D33pWat3r/Projects-for-Formula-Student-2019/Dashboard/Platinenaufbau_Platine_front.png

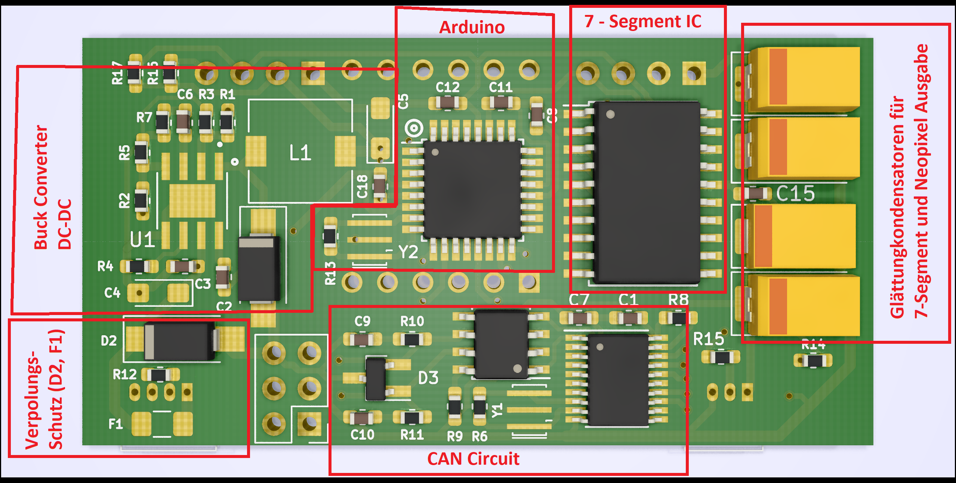
Dashboard/Platinenaufbau_Platine_front.png
