D33pWat3r/Projects-for-Formula-Student-2019/Dashboard/external Display (Add-On PCB)/Back.png

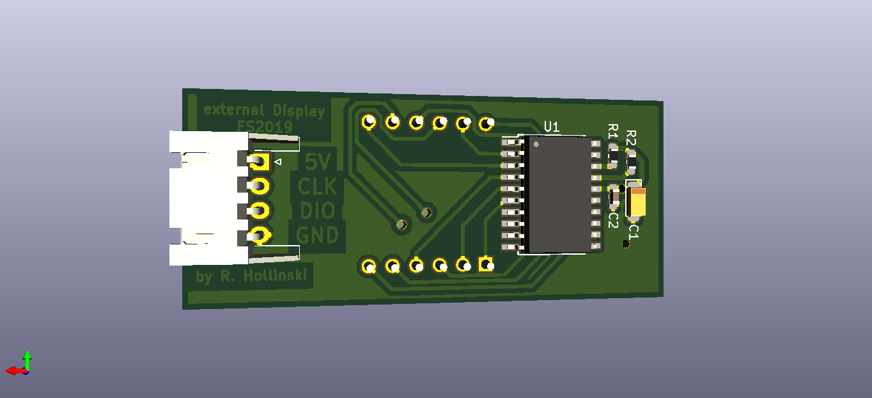
Dashboard/external Display (Add-On PCB)/Back.png
