D33pWat3r/Projects-for-Formula-Student-2019/Dashboard/OLED_vs_7Segment/Foto_vom_Steckbrett.jpg

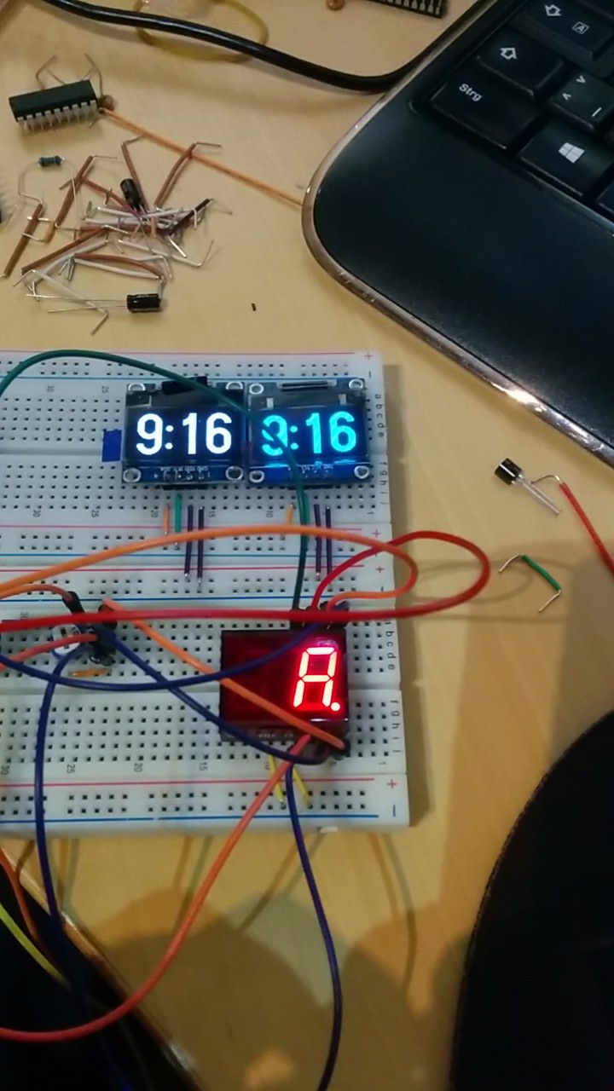
Dashboard/OLED_vs_7Segment/Foto_vom_Steckbrett.jpg
