D33pWat3r/Projects-for-Formula-Student-2019/Dashboard/PCB_KiCad_Files/RenderPictures/Platine_back_without.png

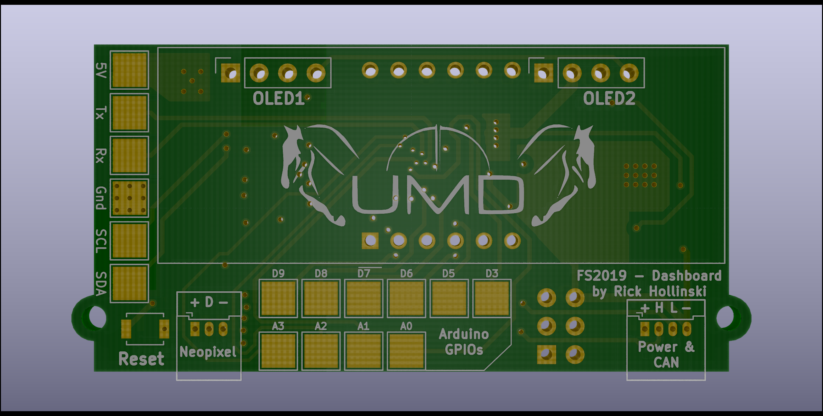
Dashboard/PCB_KiCad_Files/RenderPictures/Platine_back_without.png
