D33pWat3r/Projects-for-Formula-Student-2019/Dashboard/Platine_PinOut.png

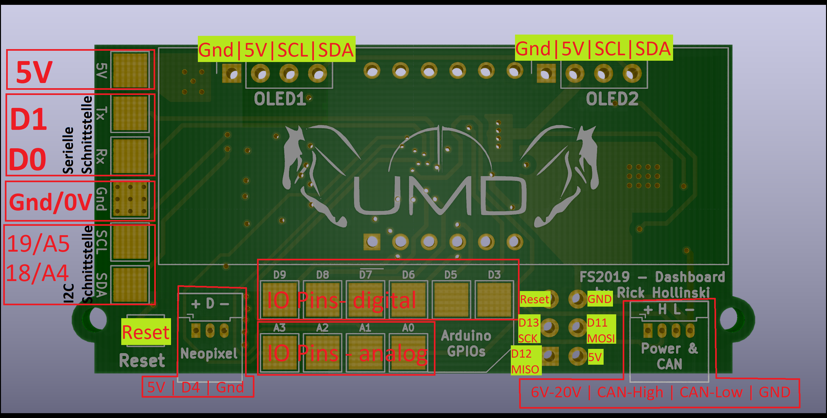
Dashboard/Platine_PinOut.png
