D33pWat3r/Projects-for-Formula-Student-2019/Dashboard/external Display (Add-On PCB)/Display.step

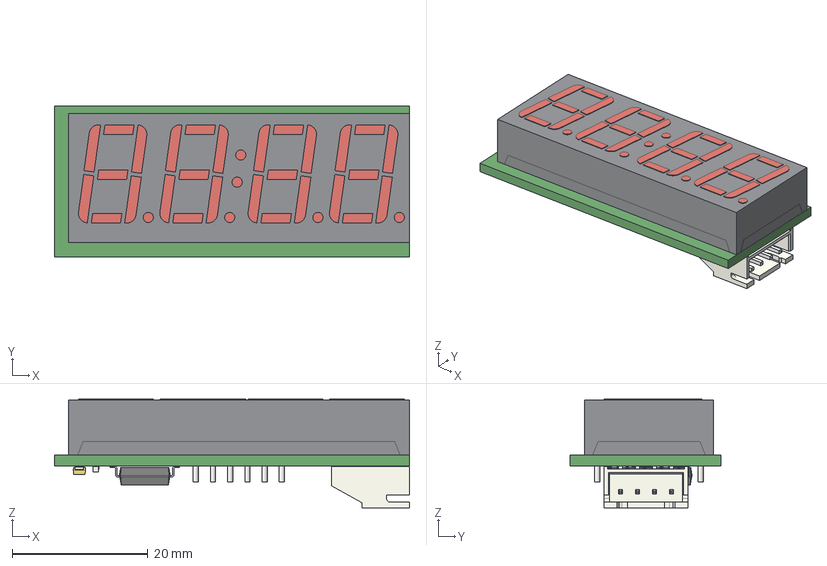
[picture p11: CAD file, 2020-06-07]
Dashboard/external Display (Add-On PCB)/Display.step
52.3 x 22.3 x 16.0 mm
