D33pWat3r/Projects-for-Formula-Student-2019/Dashboard/LED_Fassung.stl

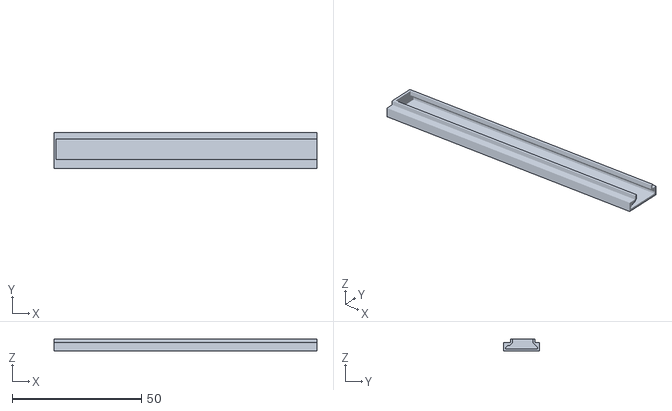
[picture p12: CAD file, 2020-06-07]
Dashboard/LED_Fassung.stl
101.8 x 14.1 x 4.80
