D33pWat3r/Projects-for-Formula-Student-2019/Dashboard/MountingBox/CFFFP_Box.3mf

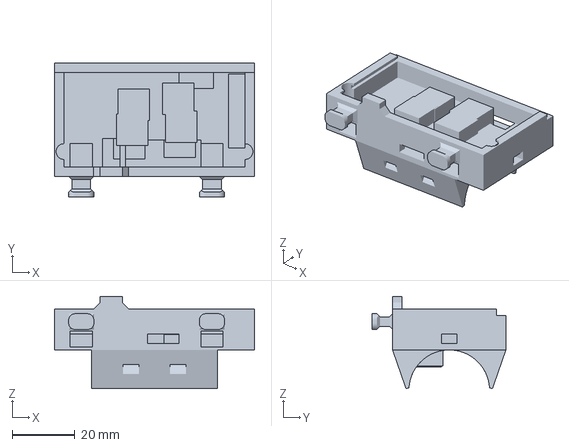
[picture p13: CAD file, 2020-06-07]
Dashboard/MountingBox/CFFFP_Box.3mf
63.5 x 42.5 x 29.3 mm
