D33pWat3r/Projects-for-Formula-Student-2019/Dashboard/PCB_KiCad_Files/3D_Modell/Dashboard PlatinenModell v1.step

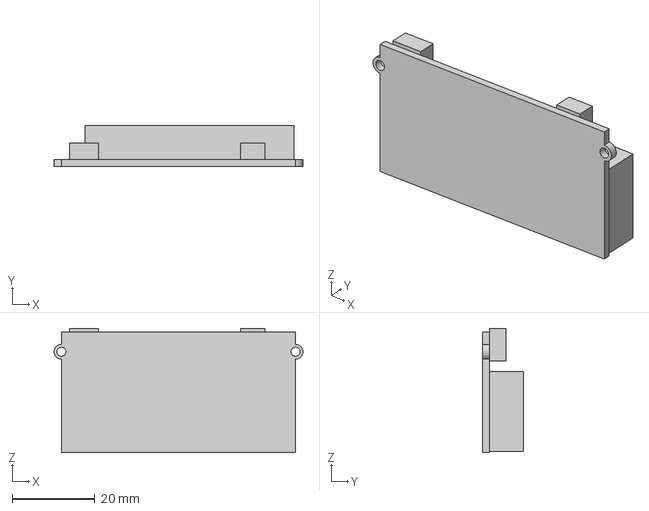
[picture p14: CAD file, 2020-06-07]
Dashboard/PCB_KiCad_Files/3D_Modell/Dashboard PlatinenModell v1.step
60.2 x 9.80 x 30.0 mm
