D33pWat3r/Projects-for-Formula-Student-2019/Dashboard/PCB_KiCad_Files/SVG/circuit-Edge.Cuts.dxf

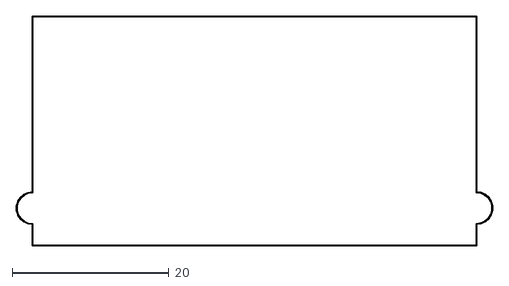
[picture p15: CAD file, 2020-06-07]
Dashboard/PCB_KiCad_Files/SVG/circuit-Edge.Cuts.dxf
60.8 x 29.3
