D33pWat3r/Projects-for-Formula-Student-2019/Dashboard/Dashboard_Panel.dxf

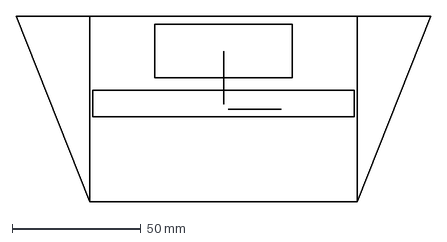
[picture p16: CAD file, 2020-06-07]
Dashboard/Dashboard_Panel.dxf
161.0 x 72.0 mm
