D33pWat3r/Projects-for-Formula-Student-2019/Dashboard/MountingBox/Box.stl

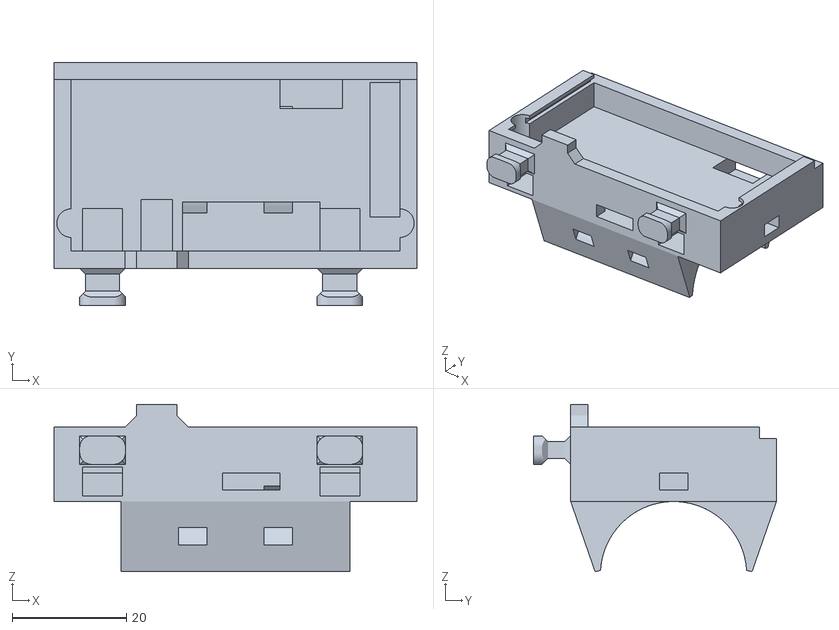
[picture p17: CAD file, 2020-06-07]
Dashboard/MountingBox/Box.stl
63.5 x 42.5 x 29.3
