D33pWat3r/Projects-for-Formula-Student-2019/Dashboard/PCB_KiCad_Files/3D_Modell/PCB_Dashboard.stl

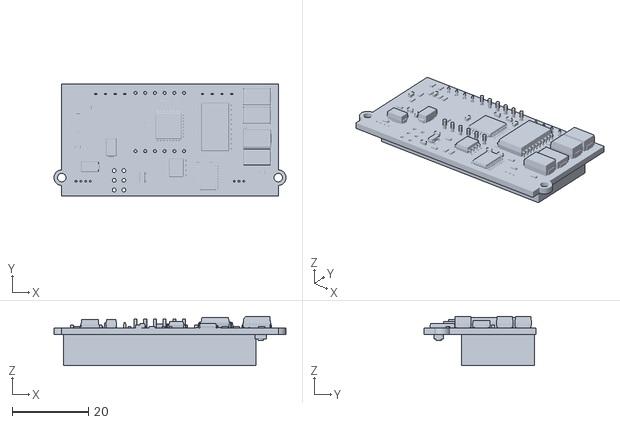
[picture p18: CAD file, 2020-06-07]
Dashboard/PCB_KiCad_Files/3D_Modell/PCB_Dashboard.stl
60.7 x 29.2 x 12.9
