D33pWat3r/Projects-for-Formula-Student-2019/Dashboard/MountingBox/Deckel.stl

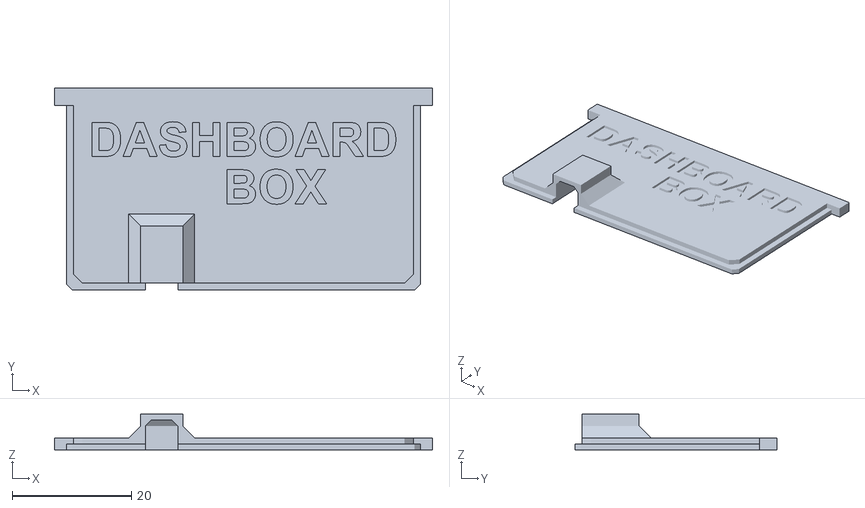
[picture p19: CAD file, 2020-06-07]
Dashboard/MountingBox/Deckel.stl
63.5 x 34.0 x 6.00
