D33pWat3r/Projects-for-Formula-Student-2019/(list of files, cad)

Other CAD files:
Dashboard/PCB_KiCad_Files/3D_Modell/Dashboard Modell.f3d
