D33pWat3r/Projects-for-Formula-Student-2019/Dashboard/SchematicFile.pdf

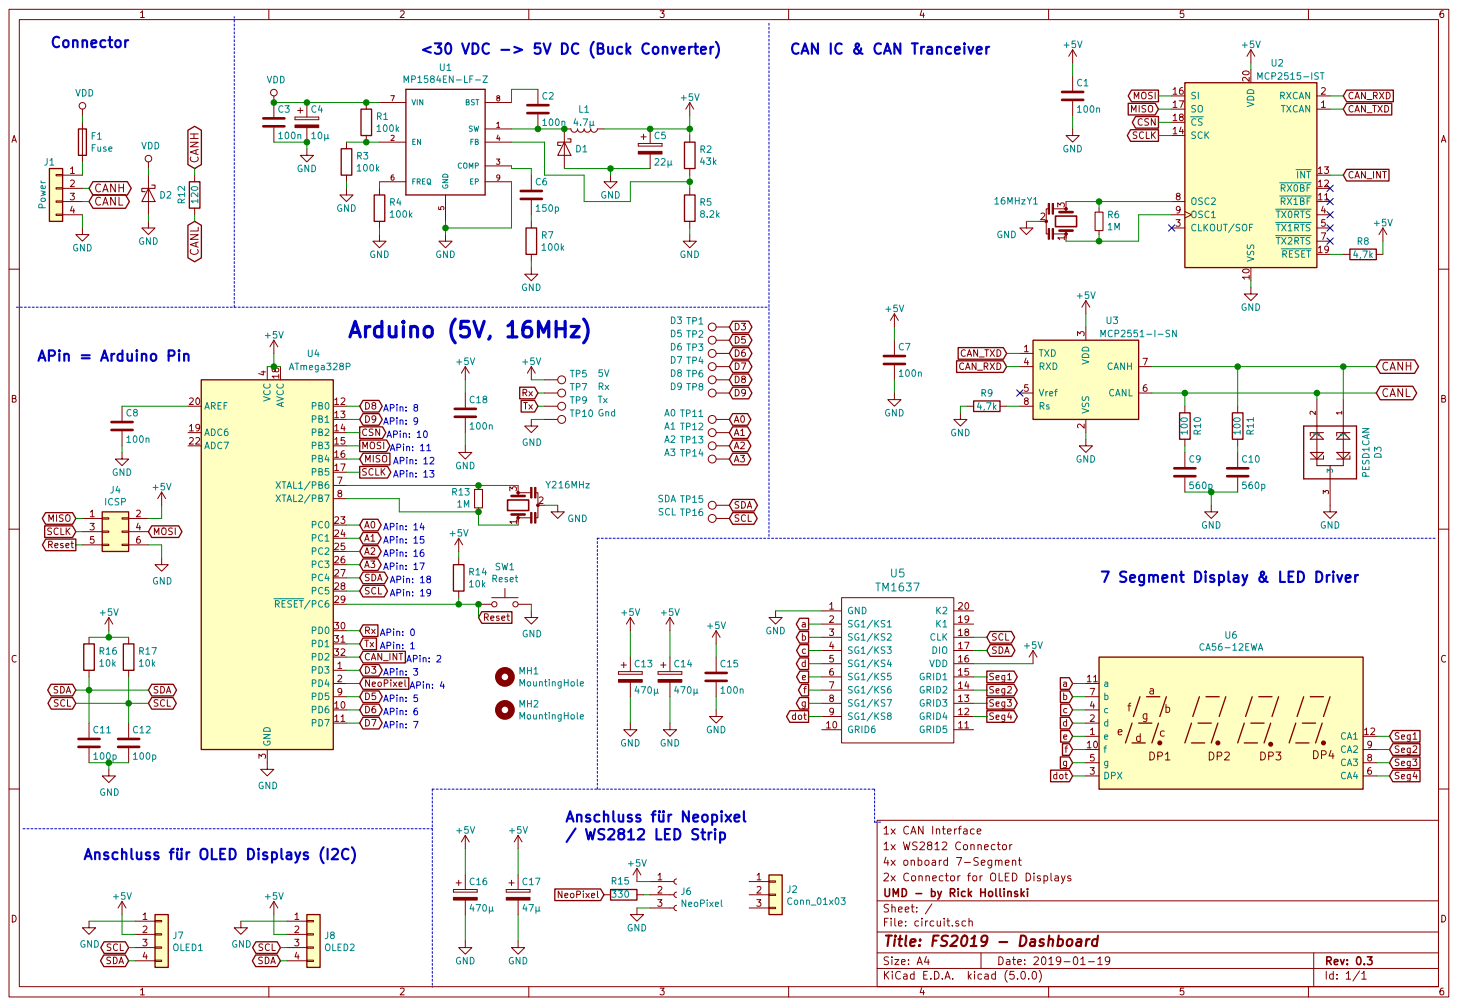
[picture p20: page 1]

<30 VDC -> 5V DC (Buck Converter) D2 VDD GNDCANH

CAN IC & CAN Tranceiver

5 FREQ 6 SW 1 COMP 3 EN 2 EP 9 BST 8 U1 MP1584EN-LF-Z R2

3 RXD 4 Vref 5 CANL 6 CANH 7 Rs 8 U3MCP2551-I-SN

J2Conn_01x03 APin: 0 APin: 1APin: 2 APin: 3APin: 4 APin: 5 APin: 7 APin: 6 APin: 8 APin: 9 APin: 10 APin: 11 APin: 12 APin: 13 APin: 14 APin: 15 APin: 16 APin: 17 APin: 18 APin: 19 APin = Arduino Pin

7 Segment Display & LED Driver

4x onboard 7-Segment 1x WS2812 Connector 1x CAN Interface

SCL SDA Anschluss für OLED Displays (I2C)

2x Connector for OLED Displays
File: circuit.sch Sheet: / UMD - by Rick Hollinski
