D33pWat3r/Projects-for-Formula-Student-2019/Dashboard/external Display (Add-On PCB)/Display.pdf

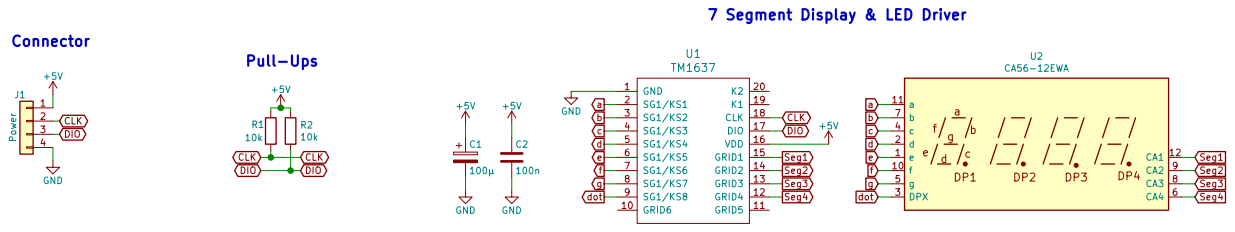
[picture p21: page 1]

File: Display.sch Sheet: /
Id: 1/1 Title:
