D33pWat3r/Projects-for-Formula-Student-2019/Dashboard/external Display (Add-On PCB)/Display.kicad_pcb

## KiCad design Dashboard/external Display (Add-On PCB)/Display.kicad_pcb (2020-06-07)

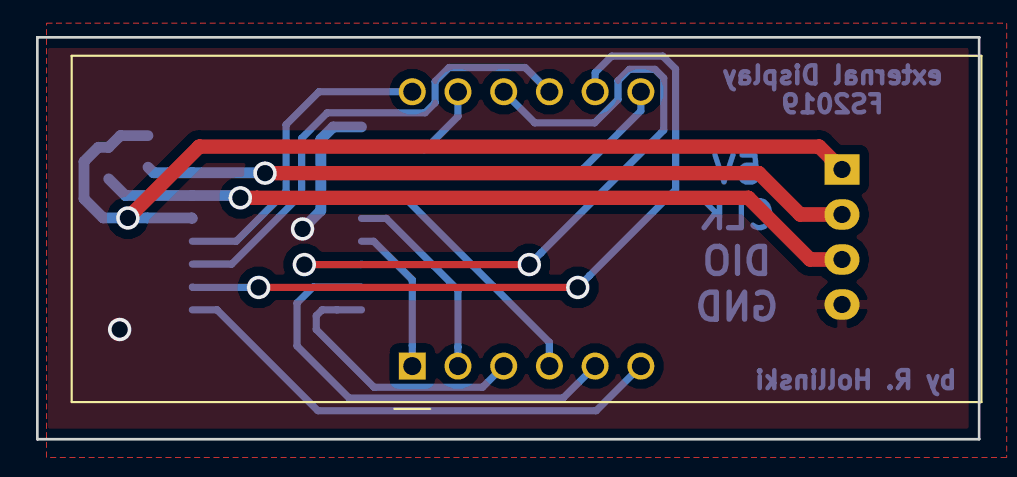
[picture p22: board Display.kicad_pcb from above]

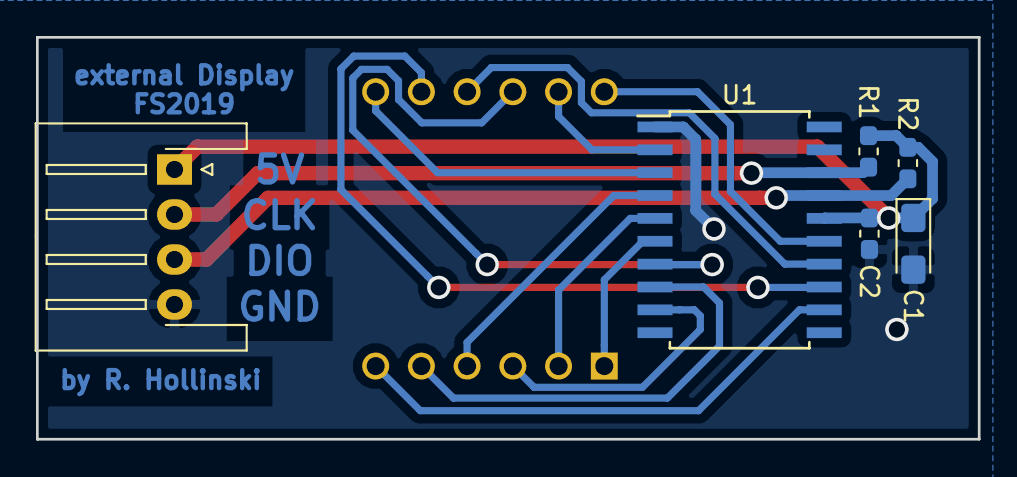
[picture p23: board Display.kicad_pcb from below]

Board: 2 copper layers, 52.3 x 22.3 mm, 7 parts (6 on the bottom side), 16 nets.

Parts:
C1: 100µ; CP_EIA-3216-10_Kemet-I_Pad1.58x1.35mm_HandSolder
C2: 100n; C_0603_1608Metric_Pad1.05x0.95mm_HandSolder
J1: Power; JST_XH_S04B-XH-A-1_1x04_P2.50mm_Horizontal
R1, R2: 10k; R_0603_1608Metric_Pad1.05x0.95mm_HandSolder
U1: TM1637; SOIC-20W_7.5x12.8mm_P1.27mm
U2: CA56-12EWA

Connections:
+5V: C1.1, C2.1, J1.1, R1.1, R2.1, U1.16
CLK: J1.2, R1.2, U1.18
DIO: J1.3, R2.2, U1.17
GND: C1.2, C2.2, J1.4, U1.1
Seg1: U1.15, U2.12
Seg2: U1.14, U2.9
Seg3: U1.13, U2.8
Seg4: U1.12, U2.6
a: U1.2, U2.11
b: U1.3, U2.7
c: U1.4, U2.4
d: U1.5, U2.2
dot: U1.9, U2.3
e: U1.6, U2.1
f: U1.7, U2.10
g: U1.8, U2.5
