D33pWat3r/Projects-for-Formula-Student-2019/Dashboard/PCB_KiCad_Files/circuit.kicad_pcb

## KiCad design Dashboard/PCB_KiCad_Files/circuit.kicad_pcb (2020-06-07)

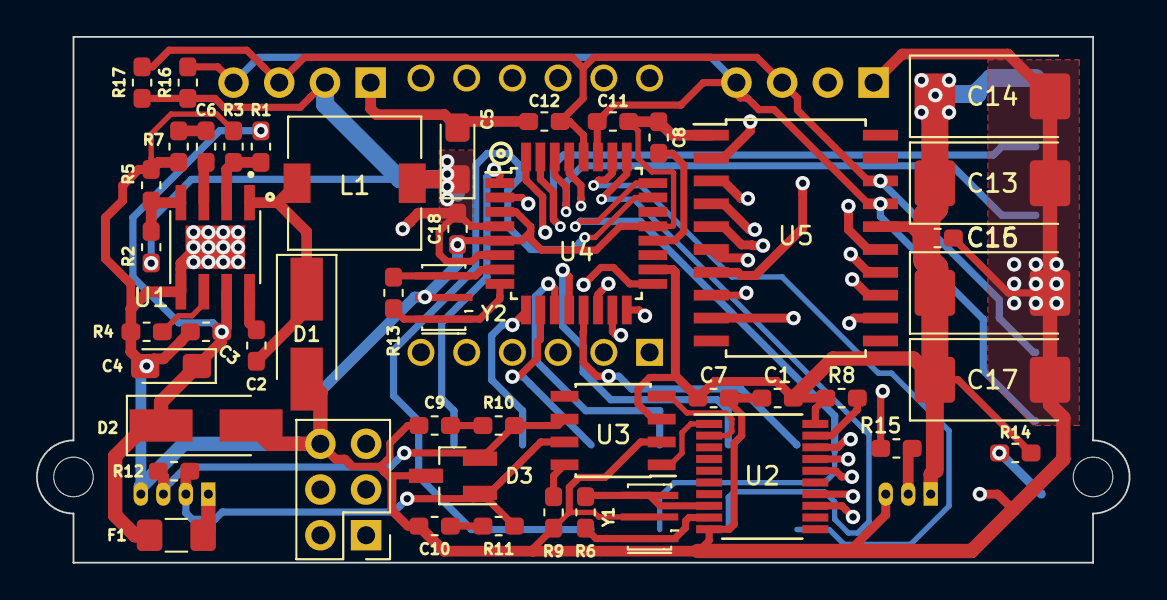
[picture p24: board circuit.kicad_pcb from above]

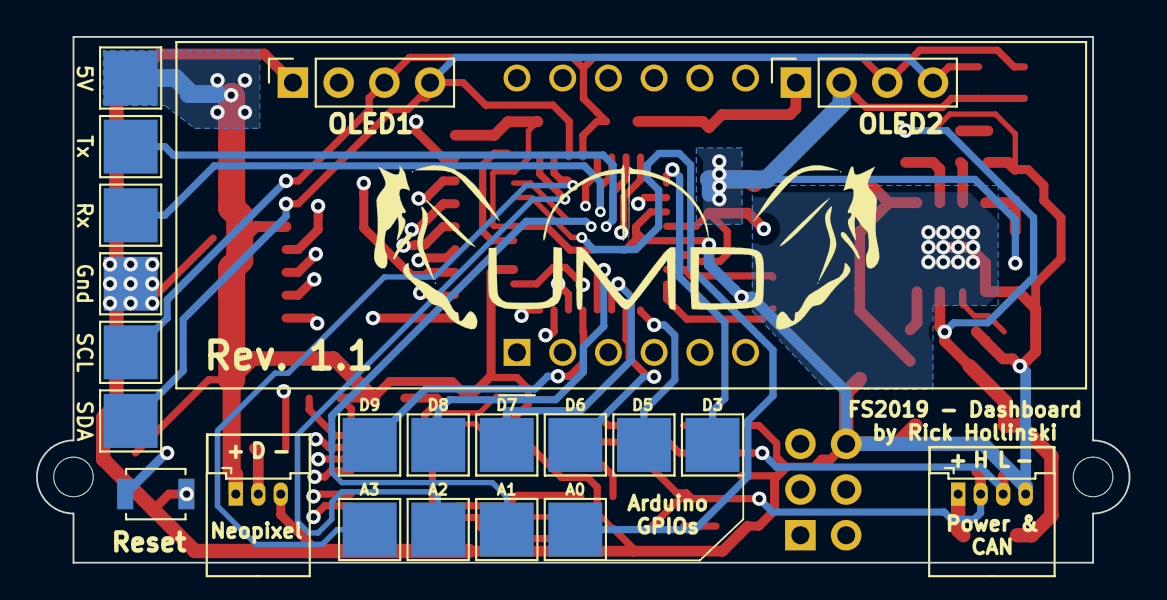
[picture p25: board circuit.kicad_pcb from below]

Board: 4 copper layers, 60.7 x 29.2 mm, 72 parts (22 on the bottom side), 58 nets.

Parts:
C1, C2, C3, C7, C8, C15, C18: 100n; C_0603_1608Metric_Pad1.05x0.95mm_HandSolder
C4: 10µ; CP_EIA-3216-10_Kemet-I_Pad1.58x1.35mm_HandSolder
C5: 22µ; CP_EIA-3216-10_Kemet-I_Pad1.58x1.35mm_HandSolder
C6: 150p; C_0603_1608Metric_Pad1.05x0.95mm_HandSolder
C9, C10: 560p; C_0603_1608Metric_Pad1.05x0.95mm_HandSolder
C11, C12: 100p; C_0603_1608Metric_Pad1.05x0.95mm_HandSolder
C13, C14, C16: 470µ; CP_EIA-7343-31_Kemet-D_Pad2.25x2.55mm_HandSolder
C17: 47µ; CP_EIA-7343-31_Kemet-D_Pad2.25x2.55mm_HandSolder
D1, D2: D_Schottky; D_SMA_Handsoldering
D3: PESD1CAN; SOT-23_Handsoldering
F1: Fuse; Fuse_1206_3216Metric_Pad1.42x1.75mm_HandSolder
J1: Power; Molex_PicoBlade_53048-0810_1x04_P1.25mm_Horizontal
J4: ICSP; PinHeader_2x03_P2.54mm_Vertical
J6: NeoPixel; Molex_PicoBlade_53048-0610_1x03_P1.25mm_Horizontal
J7: OLED1; PinSocket_1x04_P2.54mm_Vertical
J8: OLED2; PinSocket_1x04_P2.54mm_Vertical
L1: 4.7µ; L_7.3x7.3_H4.5
MH1, MH2: MountingHole; MountingHole_2.2mm_M2
R1, R3, R4, R7: 100k; R_0603_1608Metric_Pad1.05x0.95mm_HandSolder
R2: 43k; R_0603_1608Metric_Pad1.05x0.95mm_HandSolder
R5: 8.2k; R_0603_1608Metric_Pad1.05x0.95mm_HandSolder
R6, R13: 1M; R_0603_1608Metric_Pad1.05x0.95mm_HandSolder
R8, R9: 4,7k; R_0603_1608Metric_Pad1.05x0.95mm_HandSolder
R10, R11: 100; R_0603_1608Metric_Pad1.05x0.95mm_HandSolder
R12: 120; R_0603_1608Metric_Pad1.05x0.95mm_HandSolder
R14, R16, R17: 10k; R_0603_1608Metric_Pad1.05x0.95mm_HandSolder
R15: 330; R_0603_1608Metric_Pad1.05x0.95mm_HandSolder
SW1: Reset; SW_SPST_B3U-1000P
TP1: D3; TestPoint_Pad_3.0x3.0mm
TP2: D5; TestPoint_Pad_3.0x3.0mm
TP3: D6; TestPoint_Pad_3.0x3.0mm
TP4: D7; TestPoint_Pad_3.0x3.0mm
TP5: 5V; TestPoint_Pad_3.0x3.0mm
TP6: D8; TestPoint_Pad_3.0x3.0mm
TP7: Rx; TestPoint_Pad_3.0x3.0mm
TP8: D9; TestPoint_Pad_3.0x3.0mm
TP9: Tx; TestPoint_Pad_3.0x3.0mm
TP10: Gnd; TestPoint_Pad_3.0x3.0mm
TP11: A0; TestPoint_Pad_3.0x3.0mm
TP12: A1; TestPoint_Pad_3.0x3.0mm
TP13: A2; TestPoint_Pad_3.0x3.0mm
TP14: A3; TestPoint_Pad_3.0x3.0mm
TP15: SDA; TestPoint_Pad_3.0x3.0mm
TP16: SCL; TestPoint_Pad_3.0x3.0mm
U1: MP1584EN-LF-Z; SOIC127P600X170-9N
U2: MCP2515-IST; TSSOP-20_4.4x6.5mm_P0.65mm
U3: MCP2551-I-SN; SOIC-8_3.9x4.9mm_P1.27mm
U4: ATmega328P; TQFP-32_7x7mm_P0.8mm
U5: TM1637; SOIC-20W_7.5x12.8mm_P1.27mm
U6: CA56-12EWA
Y1, Y2: 16MHz; Resonator_SMD_muRata_CSTxExxV-3Pin_3.0x1.1mm_HandSoldering

Connections:
+5V: C1.1, C5.1, C7.1, C13.1, C14.1, C15.1, C16.1, C17.1, C18.1, J4.2, J6.1, J7.2, J8.2, L1.1, R2.1, R8.1, R14.1, R16.1, R17.1, TP5.1, U2.20, U3.3, U4.4, U4.6, U4.18, U5.16
A0: TP11.1, U4.23
A1: TP12.1, U4.24
A2: TP13.1, U4.25
A3: TP14.1, U4.26
CANH: D3.1, J1.2, R11.2, R12.1, U3.7
CANL: D3.2, J1.3, R10.2, R12.2, U3.6
CAN_INT: U2.13, U4.32
CAN_RXD: U2.2, U3.4
CAN_TXD: U2.1, U3.1
CSN: U2.18, U4.14
D3: TP1.1, U4.1
D5: TP2.1, U4.9
D6: TP3.1, U4.10
D7: TP4.1, U4.11
D8: TP6.1, U4.12
D9: TP8.1, U4.13
GND: C1.2, C3.2, C4.2, C5.2, C7.2, C8.2, C9.2, C10.2, C11.2, C12.2, C13.2, C14.2, C15.2, C16.2, C17.2, C18.2, D1.2, D2.2, D3.3, J1.4, J4.6, J6.3, J7.1, J8.1, R3.2, R4.2, R5.2, R7.2, R9.2, SW1.2, TP10.1, U1.5, U1.9, U2.10, U3.2, U4.3, U4.5, U4.21, U5.1, Y1.2, Y2.2
MISO: J4.1, U2.17, U4.16
MOSI: J4.4, U2.16, U4.15
NeoPixel: R15.1, U4.2
unnamed: C2.1, U1.8
unnamed: C2.2, D1.1, L1.2, U1.1
unnamed: C6.1, U1.3
unnamed: C6.2, R7.1
unnamed: C8.1, U4.20
unnamed: C9.1, R10.1
unnamed: C10.1, R11.1
unnamed: R2.2, R5.1, U1.4
unnamed: F1.2, J1.1
unnamed: J6.2, R15.2
unnamed: R1.2, R3.1, U1.2
unnamed: R4.1, U1.6
unnamed: R6.1, U2.9, Y1.1
unnamed: R6.2, U2.8, Y1.3
unnamed: R8.2, U2.19
unnamed: R9.1, U3.8
unnamed: R13.1, U4.8, Y2.1
unnamed: R13.2, U4.7, Y2.3
Reset: J4.5, R14.2, SW1.1, U4.29
Rx: TP7.1, U4.30
SCL: C12.1, J7.3, J8.3, R17.2, TP16.1, U4.28, U5.18
SCLK: J4.3, U2.14, U4.17
SDA: C11.1, J7.4, J8.4, R16.2, TP15.1, U4.27, U5.17
Seg1: U5.15, U6.12
Seg2: U5.14, U6.9
Seg3: U5.13, U6.8
Seg4: U5.12, U6.6
Tx: TP9.1, U4.31
VDD: C3.1, C4.1, D2.1, F1.1, R1.1, U1.7
a: U5.2, U6.11
b: U5.3, U6.7
c: U5.4, U6.4
d: U5.5, U6.2
dot: U5.9, U6.3
e: U5.6, U6.1
f: U5.7, U6.10
g: U5.8, U6.5
