D33pWat3r/Projects-for-Formula-Student-2019/Dashboard/Software/src/Dashboard.h

#ifndef DASHBOARD_H
#define DASHBOARD_H

#include "config.h" //Hardware Configuration

#include <Arduino.h> //Arduino Framework
#include <SPI.h>  //Arduino SPI Library

uint16_t rpm = 0;     //Engine RPM
uint16_t rpm_old = 0;
uint16_t seconds = 0; //Seconds ECU has been on
float clt; //Coolant temperature CAN in degF saved in degC
float mat; //Manifold air temperature CAN in degF saved in degC
float map1; //Manifold air pressure;
float baro; //Barometric pressure;
float batt = 12.6f; //Battery voltage;
float tps; //Throttle position;
uint8_t gear; //Current gear selected
uint16_t fuelcons; //Average fuel consumption;
uint16_t fuelflow; //Average fuel flow;
bool shift; //Shift light indicator;

// Declerations ******************************************************************************************
void updateProgress(uint8_t _state, uint8_t colorValue);
uint8_t speedLeds;
bool shiftLightIsActive = false;
uint32_t shiftLightActiveTime = 0;

// Debugging ******************************************************************************************
void initDebugging(uint32_t baud){
#if DEBUG
    Serial.begin(baud);
    #define DEBUG_PRINT_F(s)   { Serial.print(F(s)); }
    #define DEBUG_PRINT2_F(s,v) { Serial.print(F(s)); Serial.print(v); }
    #define DEBUG_PRINT(s)    { Serial.print(s); }
    #define DEBUG_PRINTLN(s)  { Serial.println(s); }
    #define DEBUG_PRINT2(x,y) { Serial.print(x,y);}
#else
    #define DEBUG_PRINT_F(s)
    #define DEBUG_PRINT2_F(s,v)
    #define DEBUG_PRINT(s)
    #define DEBUG_PRINTLN(s) 
    #define DEBUG_PRINT2(x,y)
#endif
}

// Demo Mode ******************************************************************************************
struct tDemo{
  uint8_t demoIs;
  uint8_t demoTarget;
  bool demoUp : 1;
  bool isDemoMode :1;
  bool isDemoMode_Button :1;
  uint32_t lastDemoCalc;
} demo = {0,100,true,true,false,0};

void resetDemoValue(){
  rpm =0;
  clt =0.0f;
  batt = 0.0f;
  gear = 0;
}

void demoCalcSpeed() {
  if(DEMO_RPM_BY_POTENTIOMETER){
    rpm=map(analogRead(RPM_POTI),0,1024,DEMO_RPM_POTENTIOMETER_MIN,DEMO_RPM_POTENTIOMETER_MAX);
  }else{
    if(demo.demoUp) {
      demo.demoIs++;
      
      if(demo.demoIs == demo.demoTarget) {
        demo.demoTarget = random(0, demo.demoIs - 5);
        demo.demoUp = 0;                   //fallende Drehzahl
        clt = random(60, 100);
      }

    } else {  
      demo.demoIs--;
      
      if(demo.demoIs == demo.demoTarget) {
        demo.demoTarget = random(demo.demoIs + 5, 100);
        demo.demoUp = 1;                   //steigende Drehzahl
        gear = random(gear-1, gear+2);
        if(gear < 0)
          gear = 0;
          
        if(gear > 6)
          gear = 6;
      }
    }
    rpm = NEOPIXEL_RPM_MAX / 100 * demo.demoIs ;
  }
  demo.lastDemoCalc = millis();
}


// Input Mode ******************************************************************************************
volatile uint8_t displayMode = DISPLAY_START_SCREEN;
volatile bool pushButtonIsSet = true;

void ISR_Button(){
  static uint32_t lastPushTime = 0;
  uint32_t currentPushTime = millis();
  
  if(currentPushTime - lastPushTime >= BUTTON_BOUNCE_TIME){
    #if NEOPIXEL_SHIFTLIGHT_BUTTON_TEST == 1
      shift = true;
    #else
      pushButtonIsSet = true;
      displayMode = (displayMode +1) % (DISPLAY_NUMBER_OF_SCREENS);    
      demo.isDemoMode_Button = false;
    #endif
  }
  lastPushTime = currentPushTime;
}

void initInput(void){
  pinMode(BUTTON_PIN, INPUT_PULLUP);
  attachInterrupt(digitalPinToInterrupt(BUTTON_PIN),ISR_Button,FALLING);
}

// 7-Segment ******************************************************************************************
// see http://www.fakoo.de/siekoo.html for 7-Segment Alphabet
#include "TM1637Display.h" //7-Segment Library by avishorp

TM1637Display display(DISPLAY_CLK, DISPLAY_DIO);
uint32_t lastDisplayFlash;
bool displayShow;
const uint8_t display_blank[] = { 0x00, 0x00, 0x00, 0x00 };
const uint8_t display_umd[] =  { 0b00111110, 0b00110011, 0b00100111, 0b00111111 }; //UMD
const uint8_t display_fs19[] = { 0b01110001, 0b01101101, 0b00000110, 0b01101111 }; //FS19

const uint8_t screen[][4] ={
  { 0b01101101, 0b01111000, 0b01110111, 0b01111000 }, // StAt; must be on the first position!
  { 0b10000110, 0b01111001, 0b01010100, 0b01011110 }, // 1.End
  { 0b11011011, 0b01110111, 0b01011000, 0b01011000 }, // 2.Acc 
//{ 0b11001111, 0b01111111, 0b01111111, 0b01111111 }, // 3.888     
  { 0b01011110, 0b01111001, 0b01010101, 0b00111111 },  // dEMO; must be the last entry in this array!       
  { 0b01011110, 0b01111100, 0b00011100, 0b10111101 }, //dbuG -> for debugging 
};

const uint8_t state[][4] ={
  { 0b01111100, 0b01110111, 0b01111000, 0b11111000 }, //bAtt. -> Batterie Voltage
  { 0b00111101, 0b01111001, 0b01110111, 0b11010000 }, //GEAr. -> current Gear
  { 0b00111001, 0b00111000, 0b01111000, 0b10000000 }, //CLt_. -> Engine Temperature
  //{ 0b01111000, 0b01111001, 0b01010101, 0b11110011 }, //tEMP. -> Engine Temperature    
};

void initDisplay(void){
    display.setBrightness(DISPLAY_BRIGHTNESS);
    display.setSegments(display_fs19);
    lastDisplayFlash = millis();
}

static uint8_t stateCount = 0;
static uint8_t lastTimeCount = 0;
static bool showState = true;
void refreshDisplay(){
  if(!pushButtonIsSet){
    switch(displayMode){ // the max. number of screens must be set in the "config.h"
      case(0): //different States
        if(lastTimeCount == 1) updateProgress(stateCount, (uint8_t) showState);
        switch (stateCount){
        case (0)://Batterie Voltage
          if (showState) display.setSegments(state[stateCount]);
          else{
            display.showNumberDecEx((int) (batt*10), 0b01000000, false, 3, 1);
            display.setSegments(display_blank,1,0);
          }
          break;
        case (1)://current Gear
          if (showState) display.setSegments(state[stateCount]);
          else{
            display.showNumberDec(gear, false, 1, 3);           
            display.setSegments(display_blank,3,0);
          }
          break;
        case (2)://Engine Temperature
          if (showState) display.setSegments(state[stateCount]);
          else{
            display.setSegments(display_blank,1,0);
            display.showNumberDecEx((int) (clt*10), 0b00100000, false, 4, 0);            
          }          
          break;
        }
        if(lastTimeCount == DISPLAY_STATE_DELAY_MULTIPLIER){
          lastTimeCount = 0;
          if(!showState) {stateCount=(stateCount+1)%DISPLAY_NUMBER_OF_STATES;}
          showState=!showState;
        }
        lastTimeCount++;
        
        break;    
      case(1): //Gear and Temperature -> endurance
        //display.setSegments(display_blank, 1, 1);
        display.showNumberDecEx(gear, 0x80, false, 1, 0); //x.yyy -> x= Gear; y=Temperature
        display.showNumberDec(clt, false, 3, 1);        
        break;

      case(2): //Gear and RPM -> acceleration
        //display.setSegments(display_blank, 1, 1);        
        display.showNumberDecEx(gear, 0x80, false, 1, 0); //x.yyy -> x= Gear; y=RPM
        display.showNumberDec(rpm, false, 3, 1);
        break;

      case(DISPLAY_NUMBER_OF_SCREENS+1): //Debugging
        //display.showNumberDecEx(shiftLightIsActive, 0b10000000, false, 1, 0);
        display.showNumberDec((shiftLightActiveTime/10), true, 4, 0);        
        break;
    }
  } else {
    static uint8_t localDelay = 0;
      if(localDelay == 0){
        localDelay = (uint8_t) (DISPLAY_DELAY_BY_SCREEN_CHANGE / DISPLAY_REFRESH_RATE);
        if(!demo.isDemoMode_Button) display.setSegments(screen[displayMode], 4, 0);
          else display.setSegments(screen[DISPLAY_NUMBER_OF_SCREENS], 4, 0);
      }     
      if(localDelay == 1) pushButtonIsSet = false; 
      localDelay--;
      //display.setSegments(displayBlank);
  }
}


// CAN ******************************************************************************************
#include "mcp_can.h" //CAN Library by Seeed-Studio
#include "ConvertCanData.h"

MCP_CAN CAN(CAN_SPI_CS_PIN);
tCAN_Data CanData; //CAN "Stack"

void MCP2515_ISR() {
  CanData.flagCanRecv = 1;
    if(demo.isDemoMode == 1){ //disable DemoMode add first CAN-Data recive and reset all demo values
      demo.isDemoMode = 0;
      resetDemoValue();
    }     
}

void initCAN(void){
while (CAN_OK != CAN.begin(CAN_500KBPS, MCP_16MHz))// init can bus : baudrate = 500k; 16MHz
{
    DEBUG_PRINTLN("CAN BUS Shield init fail");
    DEBUG_PRINTLN(" Init CAN BUS Shield again");
    delay(100);
}
    DEBUG_PRINTLN("CAN BUS Shield init ok!");
    attachInterrupt(digitalPinToInterrupt(CAN_INT_PIN), MCP2515_ISR, FALLING);
}


// Neopixel ******************************************************************************************
#include "Adafruit_NeoPixel.h" //WS2812b Library by Adafruit

Adafruit_NeoPixel neoPixels(NEOPIXEL_NUMBER_OF_LEDS, NEOPIXEL_PIN, NEO_GRB + NEO_KHZ800);

uint32_t lastNeoFlash;

enum BrighnessLevel {normal, high, low};
uint32_t getColor(uint8_t r, uint8_t g, uint8_t b, BrighnessLevel levelOfBrightness = normal){
  float temp0;
  if (levelOfBrightness == normal) temp0 = (NEOPIXEL_BRIGHTNESS/255.0);
  if (levelOfBrightness == high) temp0 = (NEOPIXEL_SHIFTLIGHT_BRIGHTNESS/255.0);
  if (levelOfBrightness == low) temp0 = (NEOPIXEL_RPM_LOW_BRIGHTNESS/255.0);
  uint8_t temp1 = (r * temp0);
  uint8_t temp2 = (g * temp0);
  uint8_t temp3 = (b * temp0);
  return ((uint32_t)temp1 << 16) | ((uint32_t)temp2 <<  8) | (uint32_t)temp3;
}    

const uint32_t normalWhite = getColor(255,255,255); // white
const uint32_t normalRed = getColor(255, 0, 0); // Red
const uint32_t normalGreen = getColor(0, 255, 0); // Green
const uint32_t normalYellow = getColor(255, 255, 0); // Yellow
const uint32_t normalBlue = getColor( 0, 0, 255); // Blue
const uint32_t normalOrange = getColor( 255, 120, 0); // orange
const uint32_t* normalColor[] = {&normalBlue, &normalGreen, &normalYellow, &normalRed};


const uint32_t lowRed = getColor(255, 0, 0,low); // Red
const uint32_t lowGreen = getColor(0, 255, 0,low); // Green
const uint32_t lowYellow = getColor(255, 255, 0,low); // Yellow
const uint32_t lowBlue = getColor( 0, 0, 255,low); // Blue

const uint32_t shiftLightWhite = getColor(255, 255, 255,high); // white
const uint32_t shiftLightRed = getColor(255, 0, 0,high); // Red
const uint32_t shiftLightGreen = getColor(0, 255, 0,high); // white
const uint32_t shiftLightYellow = getColor(255, 255, 0,high); // Red
const uint32_t* shiftLightColor[] = {&shiftLightRed, &shiftLightWhite, &shiftLightGreen, &shiftLightYellow};

void initNeopixel(void){
  neoPixels.begin();           // INITIALIZE NeoPixel strip object (REQUIRED)
  neoPixels.setBrightness(0xff); // Set BRIGHTNESS
  neoPixels.fill(normalOrange);
  delay(100);
  neoPixels.show(); 
  lastNeoFlash = millis();
}
// Neopixel - State ProgressBar ******************************************************************************************
const uint32_t* progressColor[] = {&normalYellow, &normalRed};
void updateProgress(uint8_t _state, uint8_t colorValue){
    const uint8_t progress = (uint8_t)(NEOPIXEL_NUMBER_OF_LEDS / DISPLAY_NUMBER_OF_STATES);
    const uint8_t halfOfRest = (NEOPIXEL_NUMBER_OF_LEDS % DISPLAY_NUMBER_OF_STATES)/2;
    neoPixels.clear();
    for(uint8_t i=(stateCount*progress)+halfOfRest;i<((stateCount*progress)+progress+halfOfRest);i++){
      neoPixels.setPixelColor(NEOPIXEL_NUMBER_OF_LEDS-i-1, *(progressColor[colorValue]));
    }
    neoPixels.show();
}

// Neopixel - RPM Band ******************************************************************************************
uint8_t fromLeft = NEOPIXEL_RPM_DIRECTION;
void updateSpeedBar() {
  if((millis() - shiftLightActiveTime) > NEOPIXEL_SHIFTLIGHT_DELAY) shiftLightIsActive = false;
  if((displayMode > 0) && (!shiftLightIsActive)){
    
    uint8_t rpmColor;
    if(rpm<=NEOPIXEL_RPM_LOW){
      speedLeds = map(rpm,0,NEOPIXEL_RPM_LOW,0,NEOPIXEL_NUMBER_OF_LEDS-NEOPIXEL_RPM_MIN_LED);      
      rpmColor = NEOPIXEL_RPM_LOW_COLOR;
      #if NEOPIXEL_RPM_DIRECTION == 2
        fromLeft = true; 
      #endif
    }
    if((rpm>NEOPIXEL_RPM_LOW) && (rpm<=NEOPIXEL_RPM_MIDDLE)){
      speedLeds = map(rpm,NEOPIXEL_RPM_LOW,NEOPIXEL_RPM_MIDDLE,0,NEOPIXEL_NUMBER_OF_LEDS-NEOPIXEL_RPM_MIN_LED);
      rpmColor = NEOPIXEL_RPM_MIDDLE_COLOR;
      #if NEOPIXEL_RPM_DIRECTION == 2
        fromLeft = false; 
      #endif
    }
    if((rpm>NEOPIXEL_RPM_MIDDLE) && (rpm<=NEOPIXEL_RPM_HIGH)){
      speedLeds = map(rpm,NEOPIXEL_RPM_MIDDLE,NEOPIXEL_RPM_HIGH,0,NEOPIXEL_NUMBER_OF_LEDS-NEOPIXEL_RPM_MIN_LED);
      rpmColor = NEOPIXEL_RPM_HIGH_COLOR;
      #if NEOPIXEL_RPM_DIRECTION == 2
        fromLeft = true; 
      #endif
    }    
    if((rpm>NEOPIXEL_RPM_HIGH) && (rpm<=NEOPIXEL_RPM_MAX)){
      speedLeds = map(rpm,NEOPIXEL_RPM_HIGH,NEOPIXEL_RPM_MAX,0,NEOPIXEL_NUMBER_OF_LEDS-NEOPIXEL_RPM_MIN_LED);
      rpmColor = NEOPIXEL_RPM_MAX_COLOR;
      #if NEOPIXEL_RPM_DIRECTION == 2
        fromLeft = false; 
      #endif
    }      

    neoPixels.clear();

    for(uint8_t a=0; a < NEOPIXEL_RPM_MIN_LED; a++) {
        if(fromLeft) neoPixels.setPixelColor(NEOPIXEL_NUMBER_OF_LEDS-1-a, *(normalColor[rpmColor]));
          else neoPixels.setPixelColor(a, *(normalColor[rpmColor]));
    }
    for(uint8_t a=0; a < speedLeds; a++) {
        if(fromLeft) neoPixels.setPixelColor(NEOPIXEL_NUMBER_OF_LEDS-1-a-NEOPIXEL_RPM_MIN_LED, *(normalColor[rpmColor]));
          else neoPixels.setPixelColor(a+NEOPIXEL_RPM_MIN_LED, *(normalColor[rpmColor]));
    }
    neoPixels.show();
    lastNeoFlash = millis();
  }

}

// Neopixel - ShiftLight ******************************************************************************************
bool isInRpmRange = false;
bool checkRpmForShiftLight(void){
  if(((NEOPIXEL_SHIFTLIGHT_CHANGE_GEAR_1-NEOPIXEL_SHIFTLIGHT_RANGE)<rpm) &&
   (rpm <(NEOPIXEL_SHIFTLIGHT_CHANGE_GEAR_1+NEOPIXEL_SHIFTLIGHT_RANGE))){
      if(!isInRpmRange){
        isInRpmRange = true;
        return true;
      } 
  }else{
    isInRpmRange = false;
  }
  return false;
}

void makeShiftLight(void){
  if(!shiftLightIsActive){
    shiftLightIsActive =true;
    neoPixels.fill(*(shiftLightColor[NEOPIXEL_SHIFTLIGHT_COLOR]));
    neoPixels.show();
    shiftLightActiveTime = millis();
    shift = false;
  }  
}

#endif
