D33pWat3r/Projects-for-Formula-Student-2019/(commit log)

2020-06-07 Datasheet for CAN controller
    CAN controller with SPI Interface
2020-06-07 Datasheet for Step-Down Converter
    simple and cheap china IC for a StepDown circuit
2020-06-07 Datasheet for LED Driver (especially for 7Segment)
    this chip can handle up to 6 digits of a 7 Segment display and has a kind of I2C Interface
2020-06-07 the Pinout for a Arduino Uno Board
    this file is from [forum.arduino.cc][https://forum.arduino.cc/index.php?topic=146315.0]
2020-06-07 Schematic file for Arduino CAN Bus shield
    this file is from "http://cdn.sparkfun.com/datasheets/Dev/Arduino/Shields/SparkFun_CAN-Bus_Shield_v13a.pdf"
2020-06-07 documentation files for Arduino CAN Bus Shield
    this files are from "https://store.arduino.cc/arduino-mkr-can-shield"
2020-06-07 gitignore for KiCad Files
2020-06-07 KiCad Project files
    [circuit.kicad_pcb, circuit.sch]
2020-06-07 Edge Cuts export Files
    [circuit-Edge.Cuts.dxf]
2020-06-07 Gerber Export File
2020-06-07 Schematic File in Version 1.0
2020-06-07 new Schematic Export Version 1.1
    add some text labels
2020-06-07 BOM Export V1.0
    generated with "Interactive HTML BOM plugin for KiCad"
2020-06-07 new BOM export for Version 1.1
2020-06-07 move files to Project Subfolder
    [circuit-Edge.Cuts.dxf, circuit.kicad_pcb, circuit.sch]
2020-06-07 Dashoard v1.0 (by Matthias Gramm)
    -read CAN Messages and save it
    -if no CAN Messages arrive, values for the demonstration are generated (RPM, Gear, Temperature)
    -use the LED Band as RPM visualisation
    -flicker the LED Band to show, that the Gear can be changing
    -show on the 4digit (7-Segment) Display the current gear and the rpm value
    -flicker the Display to show, that the engine temperature is to high
2020-06-07 Dashoard_v1.2 (by Rick Hollinski)
    -fill the config.h file with configurations to modify the software without change the algorithm
    -add a input mode to use a pushbutton
    -there are different screens (for endurance and acceleration) for the segment display, which can switch with the pushbutton
2020-06-07 Dashoard_v1.2b (by Rick Hollinski)
    -fill the config.h file with more configurations
    -add the function ,that the demo mode can be activate by the pushbutton; but this is to buggy
    [Dashboard.h, config.h, src.ino]
2020-06-07 Dashoard_v1.2c (by Rick Hollinski)
    -add new config value in the config.h
    -delete the buggy push button functions; demo Mode can not be activate by pushbutton now
    -there are new (better) text for the different screens
    -add a new CAN function to read out the shiftLed Signal; but this new value is not used now
    -add a new screen (States), which show successive different values
    -the new "state" screen use the Led Stripe to show the actual progress of max showed states
    [ConvertCanData.cpp, ConvertCanData.h, Dashboard.h, config.h, src.ino]
2020-06-07 Dashoard_v1.3 (by Rick Hollinski)
    -add much more possibilies entries in the config.h file
    -add a new RPM band function, which use for different ranges the full led stripe and show it with different colors
    -add a brightness function to show different brightness level for the led stripe
2020-06-07 add 3D Objects export
    [Dashboard Modell.f3d, Dashboard PlatinenModell v1.step, PCB_Dashboard.stl]
2020-06-07 labeled PCB Picture on the device mounted side
2020-06-07 labeled PCB Picture on the connector side
2020-06-07 different rendered pictures from KiCad
2020-06-07 mounting frame for the dashboard
    [Dashboard_Panel.dxf]
2020-06-07 socket for a WS2812 Led Stripe
    this model is for 3D print
    [LED_Fassung.stl]
2020-06-07 KiCad gitignore
2020-06-07 KiCad Project
    this PCB is designed to manufactured with a "LPKF ProtoLaser U4"
    [Display.kicad_pcb, Display.sch]
2020-06-07 BOM export
2020-06-07 Gerber export
2020-06-07 export as 3D File
    [Display.step]
2020-06-07 export of the rendered PCB
    Front and Button side
2020-06-07 Mounting Box for PCB
    [Box.stl, Deckel.stl]
2020-06-07 G-Code for "Anet A8" 3D Printer and Cura Project File
    [CFFFP_Box.3mf]
